dahan8473/tethotchi/hardware/datasheets.md

# Datasheets

Vendor PDFs aren't redistributed here. The scripts expect local copies in `hardware/datasheets/` (gitignored).

| Part | Used for | Source |
|---|---|---|
| u-blox ANNA-B112 data sheet + System Integration Manual | pinout, antenna keep-out (SIM App. B.2) | https://www.u-blox.com/en/product/anna-b112-module |
| BuyDisplay ERC12864FSF-9 (1.7", ST7567) | FPC pinout, outline, viewing area | https://www.buydisplay.com (search ERC12864FSF-9) |
| MYOUNG MY-2477-02 CR2477 clip | footprint, height | https://www.lcsc.com/product-detail/C2979175.html |
| Alps SKRTLAE010 side switch | pinout, actuator height | https://www.lcsc.com/product-detail/C110293.html |
| MLT-5020 magnetic buzzer | coil current | https://www.lcsc.com/product-detail/C94598.html |
| Epson Q13FC1350000400 32.768 kHz | load caps | https://www.lcsc.com/product-detail/C32346.html |
| JUSHUO AFA07-S14FCA-00 FPC connector | footprint | https://www.lcsc.com/product-detail/C262720.html |
