dahan8473/tethotchi/hardware/renders/concept-flat.png

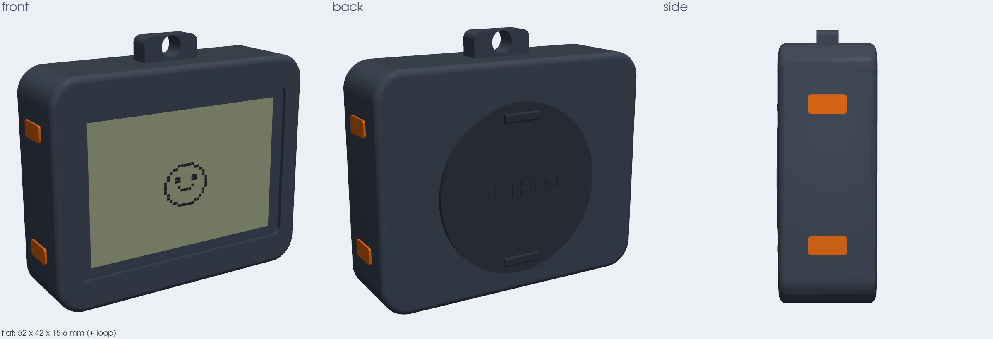
hardware/renders/concept-flat.png
