dahan8473/tethotchi/hardware/renders/floorplan.png

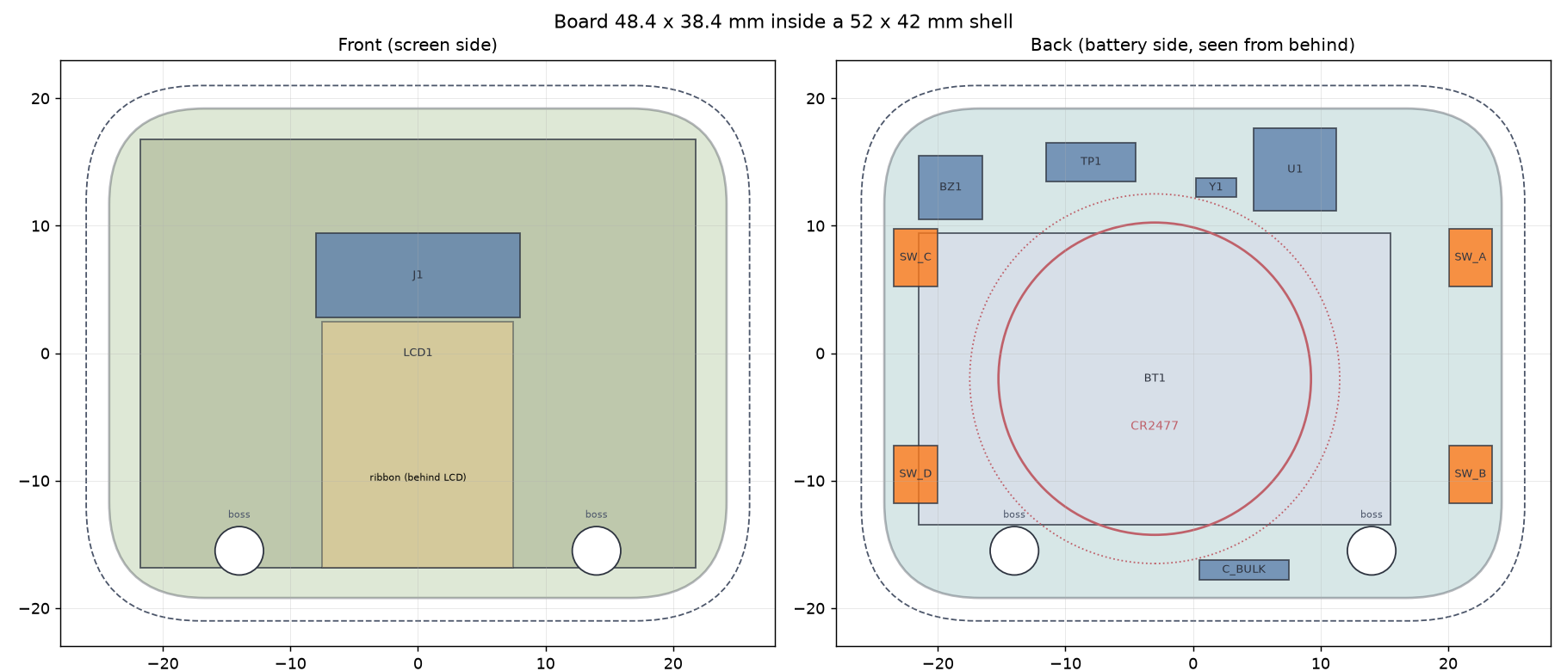
hardware/renders/floorplan.png
