dahan8473/tethotchi/hardware/renders/hero-ref-back.png

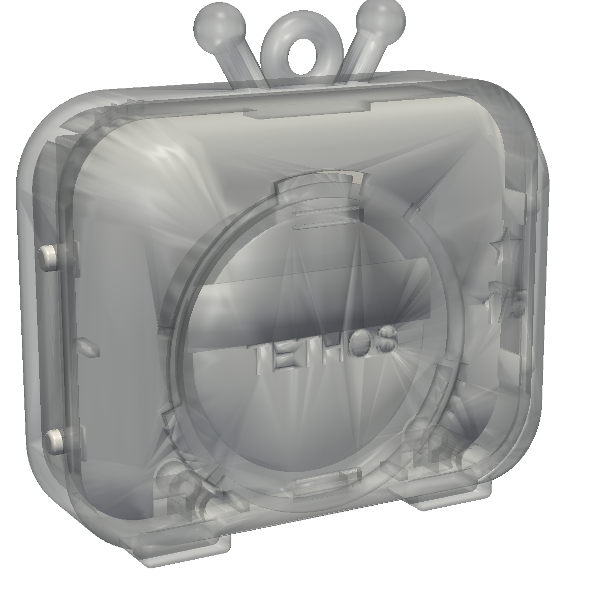
hardware/renders/hero-ref-back.png
