dahan8473/tethotchi/hardware/renders/hero-ref-front.png

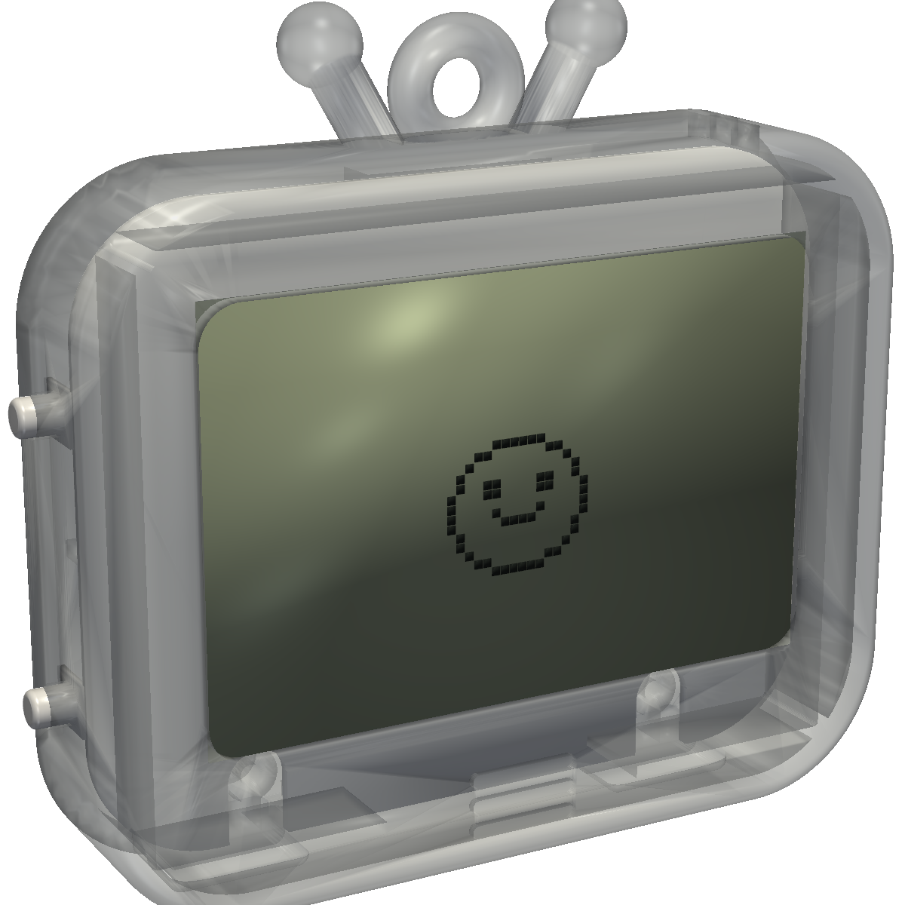
hardware/renders/hero-ref-front.png
