dahan8473/tethotchi/hardware/renders/hero-ref.png

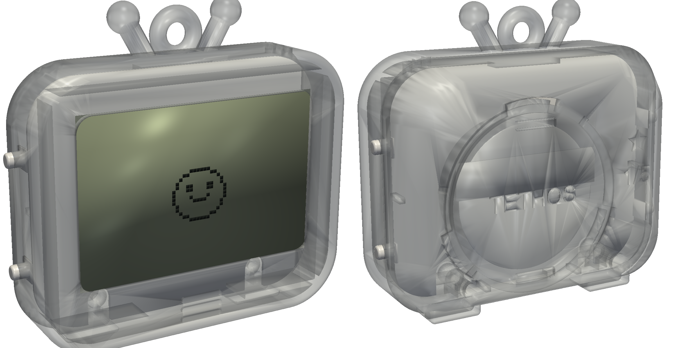
hardware/renders/hero-ref.png
