dahan8473/tethotchi/hardware/renders/pcb-back.png

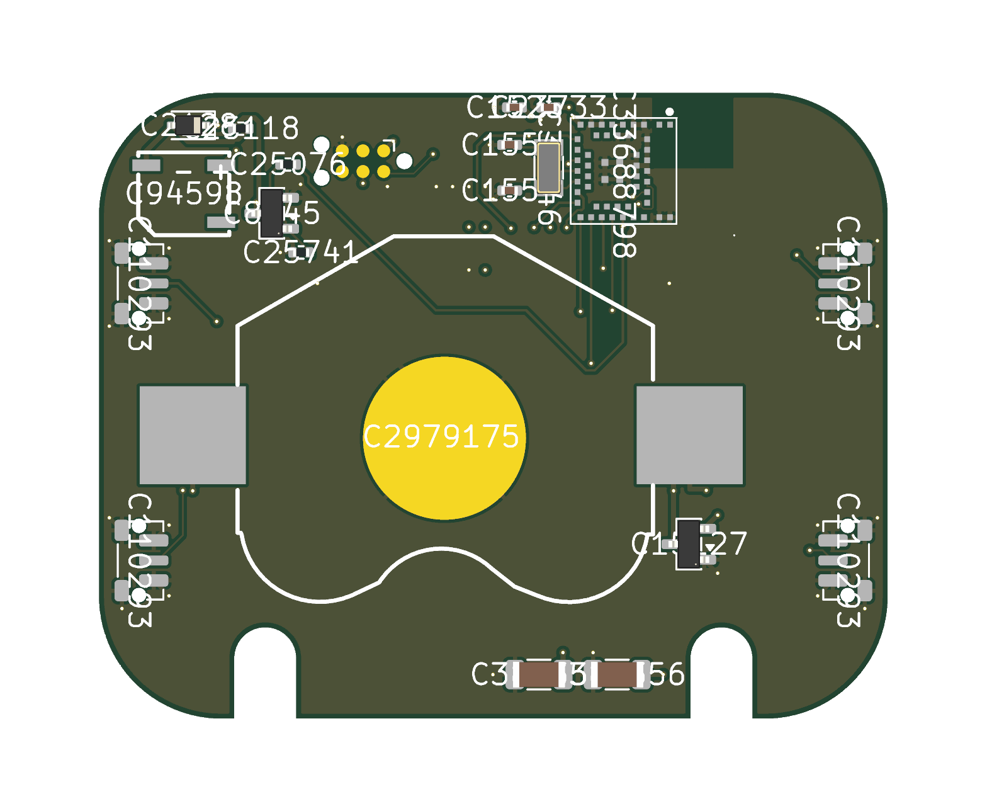
hardware/renders/pcb-back.png
