dahan8473/tethotchi/hardware/renders/pcb-front.png

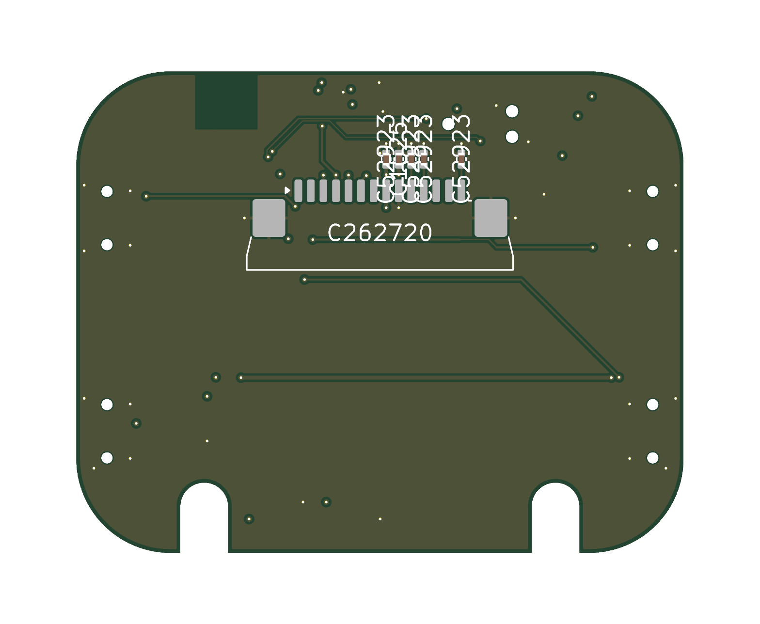
hardware/renders/pcb-front.png
