dahan8473/tethotchi/hardware/pcb/fab/bom.csv

Comment | Designator | Footprint | LCSC Part # | Note
CR2477 clip MY-2477-02 | BT1 | BAT-SMD_MY-2477-02 | C2979175
MLT-5020 | BZ1 | BUZ-SMD_L5.0-W5.5-P4.60 | C94598
100uF 6.3V X5R 1206 | C1,C2 | C_1206_3216Metric | C380356
4.7uF 10V X5R 0402 | C3 | C_0402_1005Metric | C23733
100nF 16V X7R 0402 | C11,C4 | C_0402_1005Metric | C1525
20pF C0G 0402 | C5,C6 | C_0402_1005Metric | C1554
1uF 25V X5R 0402 | C10,C7,C8,C9 | C_0402_1005Metric | C52923
1N4148WS | D1 | D_SOD-323 | C2128
1.0-B-14PWB | J1 | FPC-SMD_14P-P1.00_HDGC_1.0-B-14PWB | C2915494
2N7002 | Q1 | SOT-23 | C8545
AO3401A | Q2 | SOT-23 | C15127
47R 0402 | R1 | R_0402_1005Metric | C25118
100R 0402 | R2 | R_0402_1005Metric | C25076
100k 0402 | R3 | R_0402_1005Metric | C25741
SKRTLAE010 | SW1,SW2,SW3,SW4 | SW_Push_1P1T-MP_NO_Horizontal_Alps_SKRTLAE010 | C110293
ANNA-B112 | U1 | BULETM-SMD_ANNA-B112 | C33688798
32.768kHz 12.5pF 3215 | Y1 | Crystal_SMD_3215-2Pin_3.2x1.5mm | C32346
