dahan8473/tethotchi/hardware/shell/concepts/crt.stl

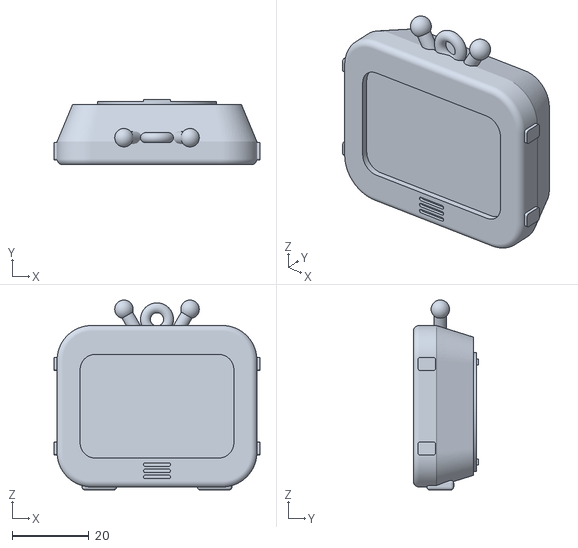
[picture p14: CAD file, 2026-10-09]
hardware/shell/concepts/crt.stl
53.6 x 17.0 x 49.4
