dahan8473/tethotchi/hardware/shell/out/back.step

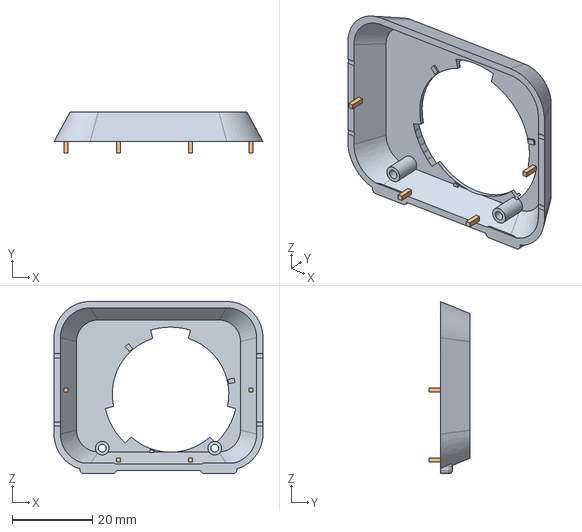
[picture p15: CAD file, 2026-10-10]
hardware/shell/out/back.step
52.0 x 10.3 x 42.8 mm
