dahan8473/tethotchi/hardware/shell/concepts/flat.stl

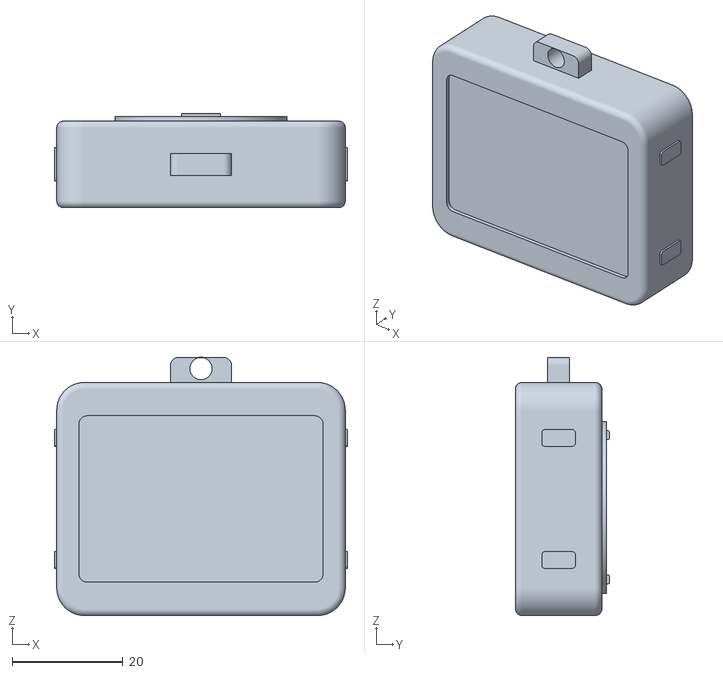
[picture p16: CAD file, 2026-10-09]
hardware/shell/concepts/flat.stl
52.8 x 17.0 x 46.5
