dahan8473/tethotchi/hardware/shell/out/front.step

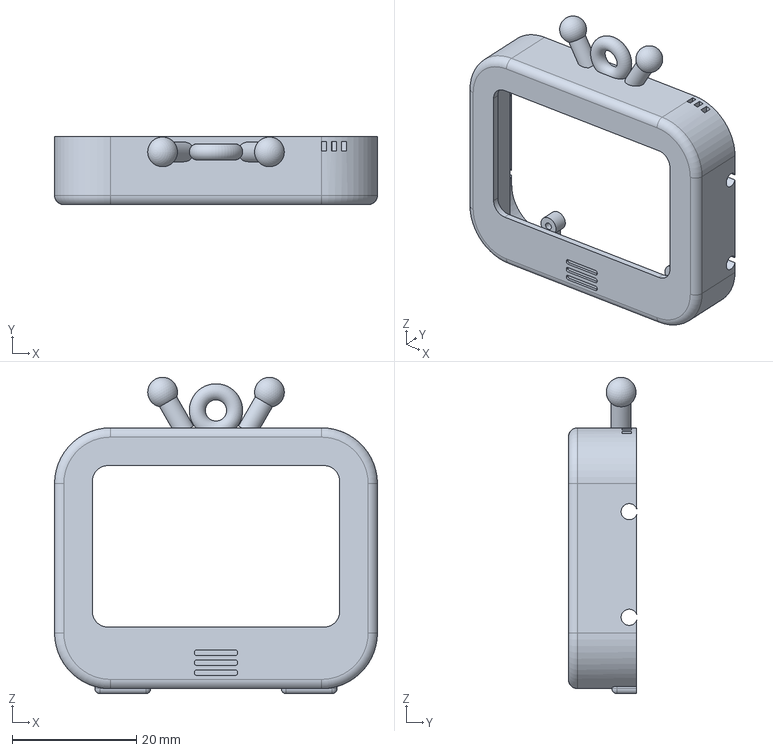
[picture p17: CAD file, 2026-10-10]
hardware/shell/out/front.step
52.0 x 11.0 x 50.9 mm
