dahan8473/tethotchi/hardware/shell/out/button.step

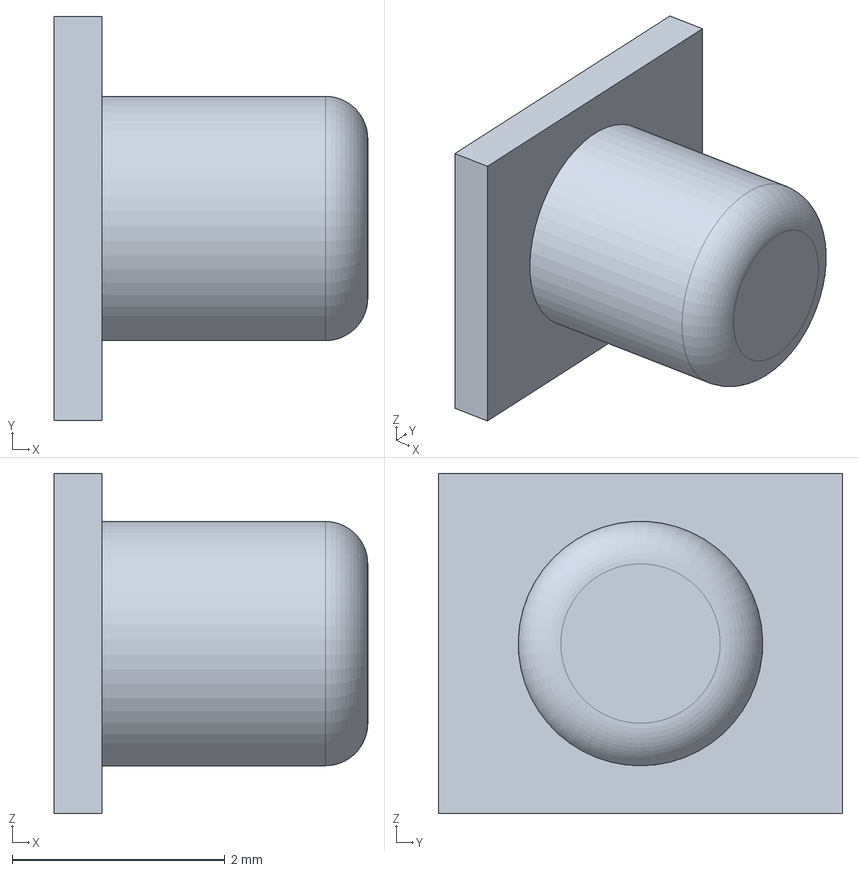
[picture p18: CAD file, 2026-10-10]
hardware/shell/out/button.step
2.95 x 3.80 x 3.20 mm
