dahan8473/tethotchi/hardware/shell/out/cap_25.step

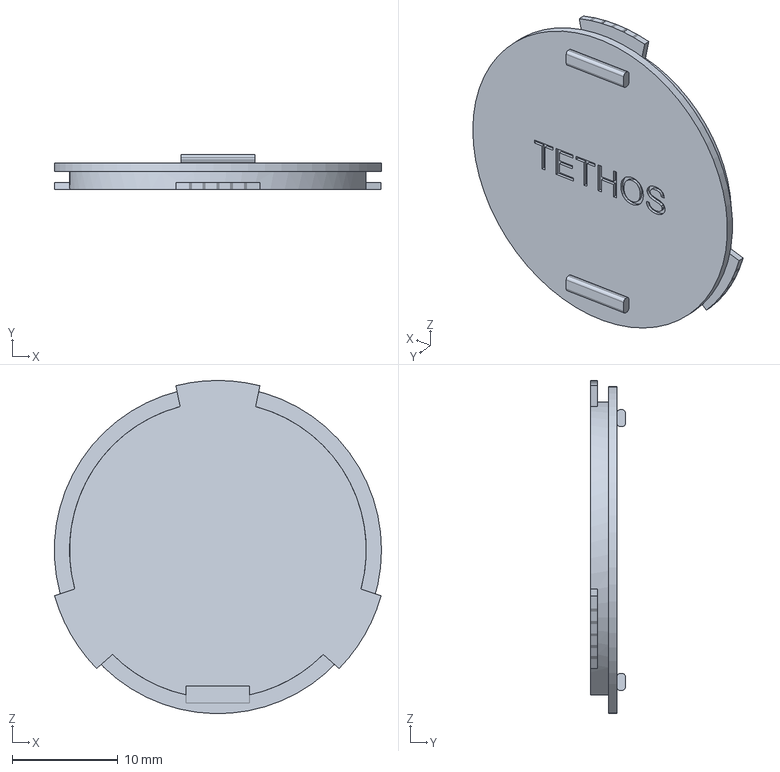
[picture p19: CAD file, 2026-10-10]
hardware/shell/out/cap_25.step
31.0 x 3.30 x 31.6 mm
