dahan8473/tethotchi/hardware/shell/out/cap_35.step

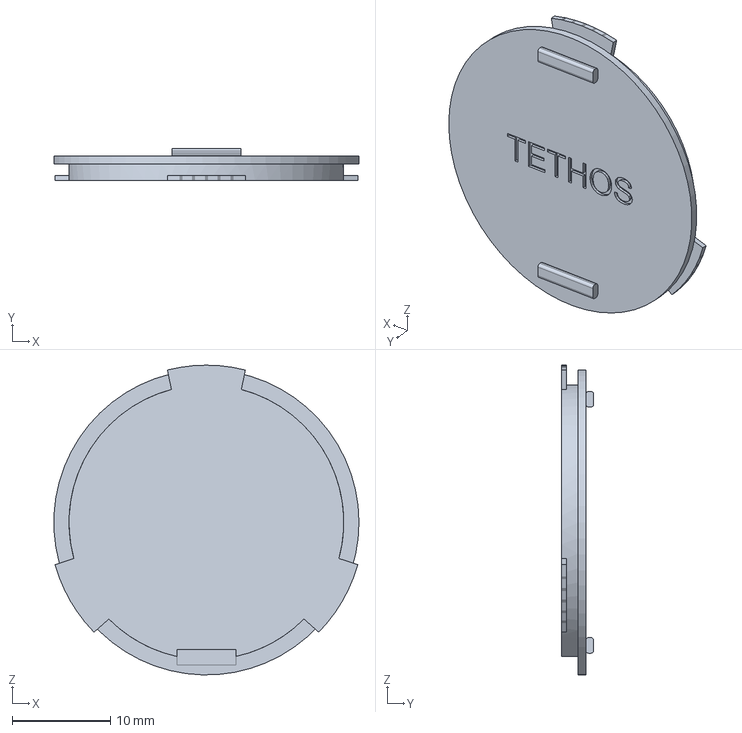
[picture p20: CAD file, 2026-10-10]
hardware/shell/out/cap_35.step
31.0 x 3.30 x 31.5 mm
