dahan8473/tethotchi/hardware/shell/out/button_sprue.step

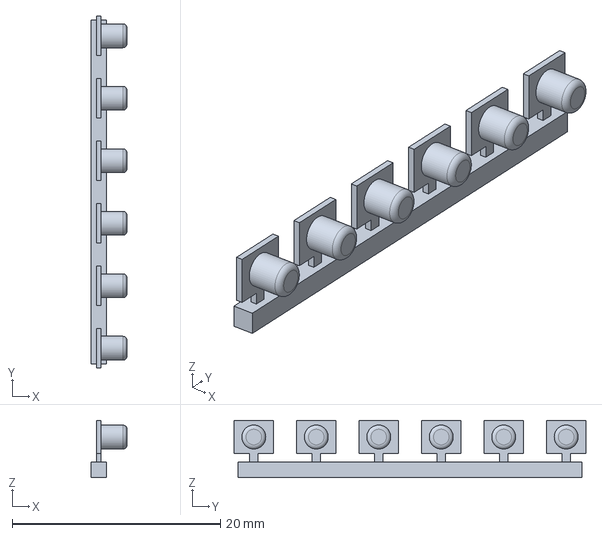
[picture p21: CAD file, 2026-10-10]
hardware/shell/out/button_sprue.step
3.48 x 33.8 x 5.50 mm
