dahan8473/tethotchi/(list of files, cad)

Other CAD files:
hardware/shell/out/back_2of5.step
hardware/shell/out/back_1of5.step
hardware/shell/out/back_4of5.step
hardware/shell/out/back_5of5.step
hardware/shell/out/back_3of5.step
hardware/shell/out/cap_15.step
hardware/shell/out/back.stl
hardware/shell/out/back_1of5.stl
hardware/shell/out/back_2of5.stl
hardware/shell/out/back_3of5.stl
hardware/shell/out/back_4of5.stl
hardware/shell/out/back_5of5.stl
hardware/shell/out/button.stl
hardware/shell/out/button_sprue.stl
hardware/shell/out/cap_15.stl
hardware/shell/out/cap_25.stl
hardware/shell/out/cap_35.stl
hardware/shell/out/front.stl
