dahan8473/tethotchi/hardware/pcb/tethos-pet.kicad_pcb

## KiCad design hardware/pcb/tethos-pet.kicad_pcb (2026-10-10)

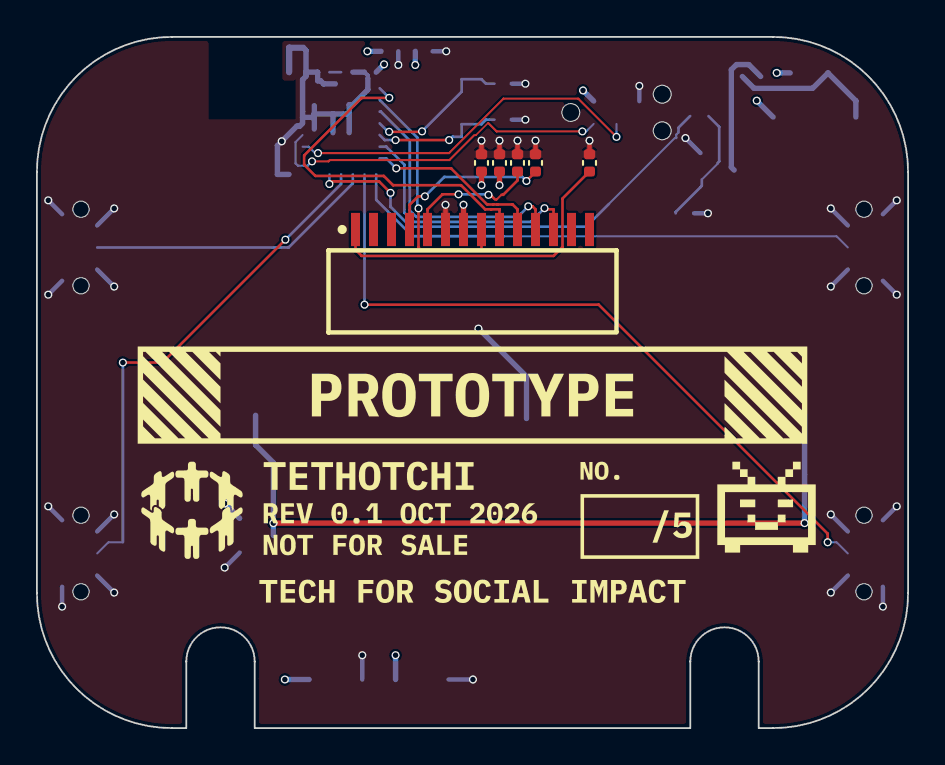
[picture p22: board tethos-pet.kicad_pcb from above]

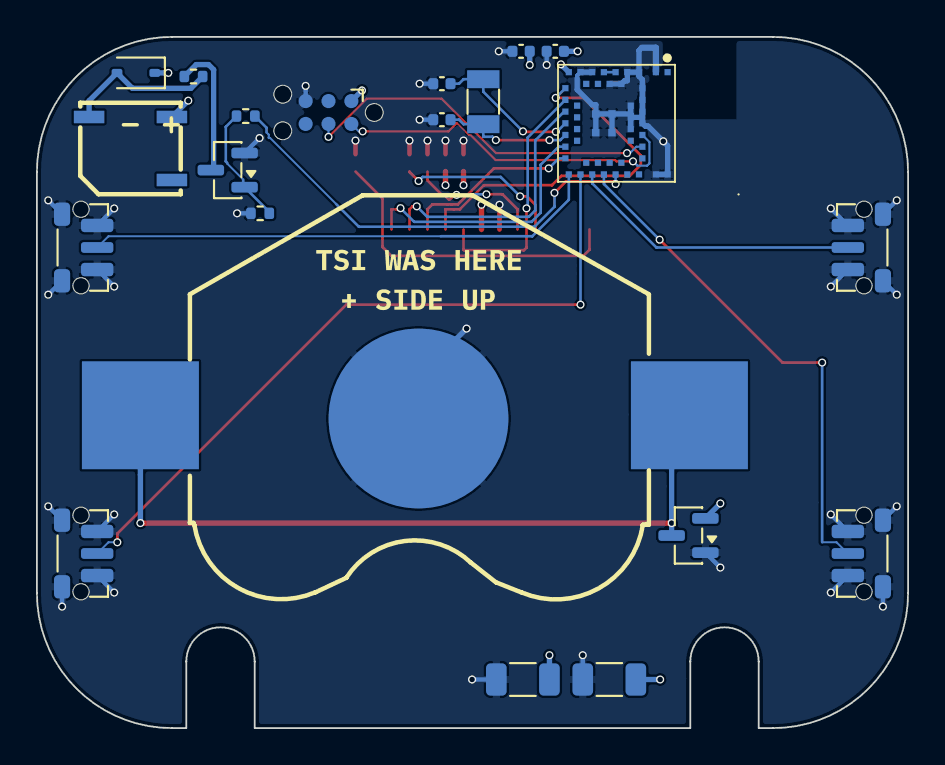
[picture p23: board tethos-pet.kicad_pcb from below]

Board: 4 copper layers, 48.4 x 38.4 mm, 27 parts (21 on the bottom side), 24 nets.

Parts:
BT1: CR2477 clip MY-2477-02; BAT-SMD_MY-2477-02
BZ1: MLT-5020; BUZ-SMD_L5.0-W5.5-P4.60
C1, C2: 100uF 6.3V X5R 1206; C_1206_3216Metric
C3: 4.7uF 10V X5R 0402; C_0402_1005Metric
C4, C11: 100nF 16V X7R 0402; C_0402_1005Metric
C5, C6: 20pF C0G 0402; C_0402_1005Metric
C7, C8, C9, C10: 1uF 25V X5R 0402; C_0402_1005Metric
D1: 1N4148WS; D_SOD-323
J1: 1.0-B-14PWB; FPC-SMD_14P-P1.00_HDGC_1.0-B-14PWB
Q1: 2N7002; SOT-23
Q2: AO3401A; SOT-23
R1: 47R 0402; R_0402_1005Metric
R2: 100R 0402; R_0402_1005Metric
R3: 100k 0402; R_0402_1005Metric
SW1, SW2, SW3, SW4: SKRTLAE010; SW_Push_1P1T-MP_NO_Horizontal_Alps_SKRTLAE010
TP1: TC2030-NL; Tag-Connect_TC2030-IDC-NL_2x03_P1.27mm_Vertical
U1: ANNA-B112; BULETM-SMD_ANNA-B112
Y1: 32.768kHz 12.5pF 3215; Crystal_SMD_3215-2Pin_3.2x1.5mm

Connections:
ANT_FEED: U1.5, U1.6
BTN_A: SW1.2, U1.27
BTN_B: SW2.2, U1.28
BTN_C: SW3.2, U1.25
BTN_D: SW4.2, U1.26
BUZZ: R2.1, U1.29
BUZZ_G: Q1.1, R2.2, R3.1
BZ_D: Q1.3, R1.2
BZ_R: BZ1.2, D1.2, R1.1
GND: BT1.3, C1.2, C2.2, C3.2, C4.2, C5.2, C6.2, C7.2, C8.2, C9.2, C10.2, C11.2, J1.6, Q1.2, Q2.1, R3.2, SW1.1, SW1.MP, SW2.1, SW2.MP, SW3.1, SW3.MP, SW4.1, SW4.MP, TP1.5, U1.2, U1.3, U1.4, U1.7, U1.8, U1.10, U1.11, U1.32, U1.33, U1.41, U1.42, U1.43, U1.44, U1.46, U1.47, U1.48, U1.49, U1.50, U1.51, U1.52
LCD_A0: J1.10, U1.20
LCD_CS: J1.12, U1.19
LCD_RST: J1.11, U1.16
LCD_SCL: J1.9, U1.14
LCD_SDA: J1.8, U1.15
LCD_V0: C7.1, J1.5
LCD_VG: C9.1, J1.1
LCD_XV0: C8.1, J1.4
SWDCLK: TP1.4, U1.39
SWDIO: TP1.2, U1.40
VBAT: BZ1.1, C1.1, C2.1, C3.1, C4.1, C10.1, C11.1, D1.1, J1.7, Q2.2, TP1.1, U1.9
VCELL: BT1.1, BT1.2, Q2.3
XL1: C5.1, U1.17, Y1.1
XL2: C6.1, U1.18, Y1.2
