dahan8473/tethotchi/(commit log)

2026-10-09 Hardware v0.1: CRT shell, routed 4-layer PCB, JLC fab files
    - layout.py / circuit.py as the single source for placement and netlist
    - build123d shell (front, back, 3 twist-cap fit variants, button plungers) with fit check
    - KiCad 10 board: ANNA-B112 edge antenna per SIM App. B.2, Freerouting, DRC 0/0
    - JLC gerbers, BOM (U1 consigned), CPL
    - early firmware scaffold and vendored mcumgr web client
    [back.step, back.stl, bom.csv, button.step, button.stl, cap_15.step, cap_15.stl, cap_25.step]
2026-10-10 Numbered 1/5..5/5 backs for the first run, U1 from JLC stock
    - shell.py: star + edition number debossed beside the cap, back_Nof5 exports
    - export_fab.py: RUN_QTY = 5, consign U1 only past JLC's stock
    - edition-backs render, README updates
    [back.step, back_1of5.step, back_1of5.stl, back_2of5.step, back_2of5.stl, back_3of5.step, back_3of5.stl, back_4of5.step]
2026-10-10 Tethotchi: PROTOTYPE board art, JLC fixes, button sprue, public README
    - silkscreen art generator (art/make_art.py) and stamper (pcb/add_art.py)
    - vias 0.45/0.3 mm (JLC no-fee size), annular min 0.075
    - CPL corrections for J1, D1, BZ1 from JLC's placement preview
    - 6-up button sprue (JLC3DP minimum part size)
    - ORDER.md, datasheets.md (vendor PDFs no longer tracked), root README
    [back.step, back_1of5.step, back_2of5.step, back_3of5.step, back_4of5.step, back_5of5.step, button.step, button_sprue.step]
2026-10-10 Board art reads TETHOTCHI; product-shot reference renders
    [tethos-pet.kicad_pcb, tethos-pet.routed-ok.kicad_pcb]
2026-10-10 J1: dual-contact FPC, nets mirrored for the folded ribbon
    ERC12864-9 outline (third-angle): LCD pin 1 is on the right seen from the front and the
    tail contacts are on the back face. After the 180 deg fold behind the LCD the contacts face
    away from the PCB and pin 1 lands on the right, so the bottom-contact AFA07 with pad n = pin n
    would not have worked.
    - J1 -> HDGC 1.0-B-14PWB (C2915494), contacts top and bottom, 2.85 mm
    - pad k = LCD pin 15-k; pads at z 8.5 so the ribbon tip gets ~3 mm insertion
    - LCD gap 2.8 -> 3.1 mm, shell depth 18.1 -> 18.4 mm; rerouted, DRC 0/0, fit check clean
    - JLC CPL: J1 needs no correction with this footprint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
    [back.step, back.stl, back_1of5.step, back_1of5.stl, back_2of5.step, back_2of5.stl, back_3of5.step, back_3of5.stl]
